ngalin/JillTrak/hardware/enclosure/renders/leads.png

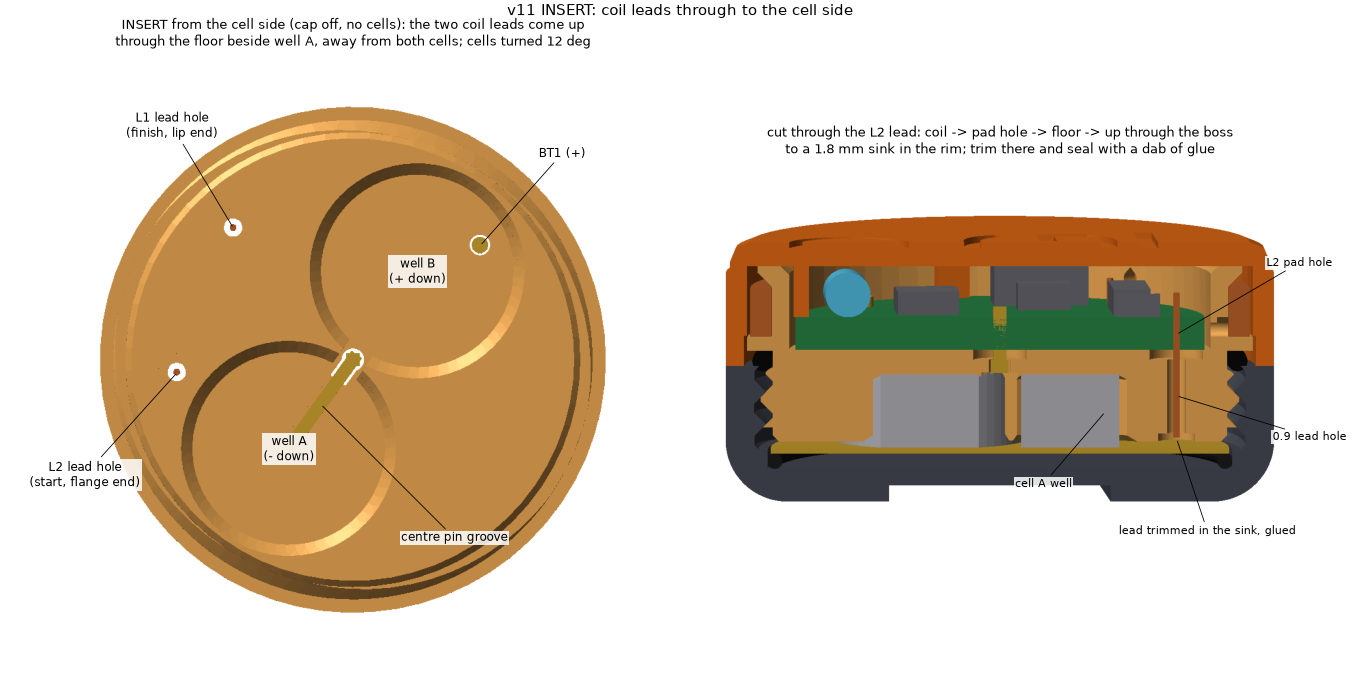
hardware/enclosure/renders/leads.png
