ngalin/JillTrak/hardware/enclosure/renders/thread.png

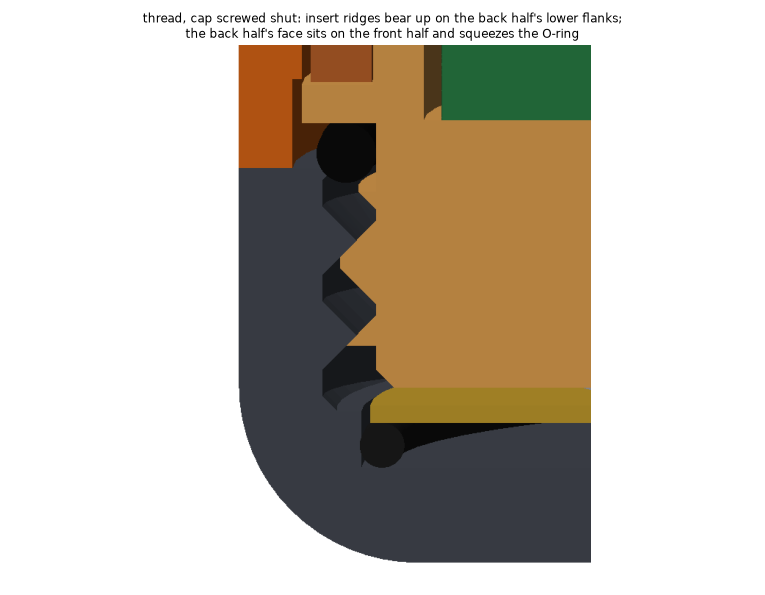
hardware/enclosure/renders/thread.png
