ngalin/JillTrak/hardware/pcb/tx-kick/bom.csv

Comment | Designator | Footprint | LCSC
Battery + side pin, 1.0mm, hand-fit | BT1 | Batt_Pos_SidePin_D1.0
Battery - centre pin, 1.0mm, hand-fit | BT2 | Batt_Neg_CentrePin_D1.0
Tank, 100nF C0G/NP0 50V | C1 | C_1206_3216Metric
Tank trim, C0G/NP0, fit only if needed | C1T | C_0603_1608Metric
100nF X7R 16V | C3 | C_0402_1005Metric
10uF X5R 6.3V | C4 | C_0603_1608Metric
100-220uF 6.3V polymer tantalum, case B (e.g. KEMET T520B) | C5 | CP_EIA-3528-21_Kemet-B
22uF X5R 6.3V | C5B | C_0805_2012Metric
Coil wire A, hand-solder | L1 | Coil_Wire_D0.7
Coil wire B, hand-solder | L2 | Coil_Wire_D0.7
AO3400A N-MOSFET, reverse-polarity | Q1 | SOT-23
AO3400A N-MOSFET, kick switch | Q2 | SOT-23
47R 1% | RF,RG | R_0402_1005Metric
100k 1% | RPD | R_0402_1005Metric
10k 1% | RR | R_0402_1005Metric
Standex-Meder MK24-B-2 reed, lead design 2 | SW1 | Reed_MK24_LeadDesign2
ATtiny85-20SU, SOIC-8 0.208 in | U1 | SOIC-8_5.23x5.23mm_P1.27mm
