ngalin/JillTrak/hardware/pcb/tx-kick/tx-kick_bom_jlc.csv

Comment | Designator | Footprint | JLCPCB Part #（optional）
100nF C0G | C1 | C1206 | C2940749
100nF | C3 | C0402 | C1525
10uF | C4 | C0603 | C19702
220uF | C5 | CAP-SMD_L3.5-W2.8 | C2158369
22uF | C5B | C0805 | C45783
AO3400A | Q1,Q2 | SOT-23-3 | C20917
47R | RF,RG | R0402 | C25118
100K | RPD | R0402 | C25741
10K | RR | R0402 | C25744
ATTINY85-20SU | U1 | SOIC-8_L5.3-W5.3-P1.27 | C31540447
