ngalin/JillTrak/hardware/enclosure/stl/insert.stl

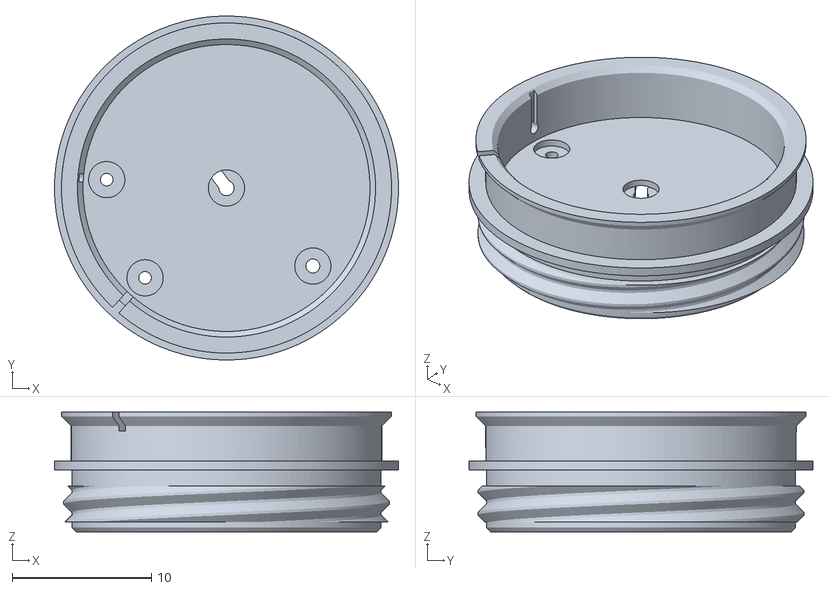
[picture p13: CAD file, 2026-10-30]
hardware/enclosure/stl/insert.stl
24.7 x 24.7 x 8.60
