ngalin/JillTrak/hardware/enclosure/stl/cap.stl

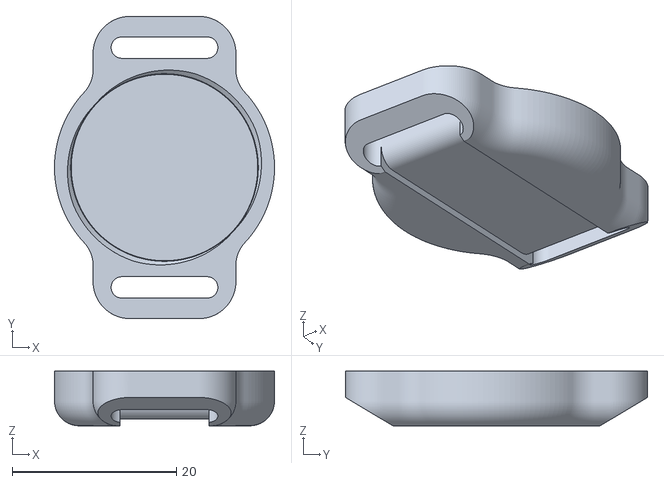
[picture p14: CAD file, 2026-10-30]
hardware/enclosure/stl/cap.stl
26.8 x 36.8 x 6.65
