ngalin/JillTrak/hardware/enclosure/stl/shell.stl

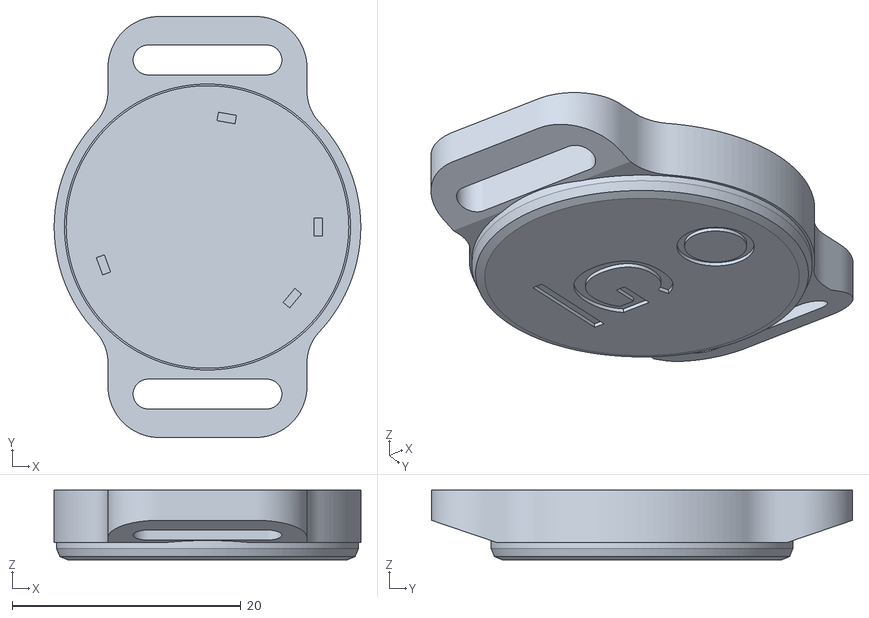
[picture p15: CAD file, 2026-10-30]
hardware/enclosure/stl/shell.stl
26.8 x 36.8 x 6.10
