ngalin/JillTrak/hardware/pcb/tx-kick/tx-kick-schematic.pdf

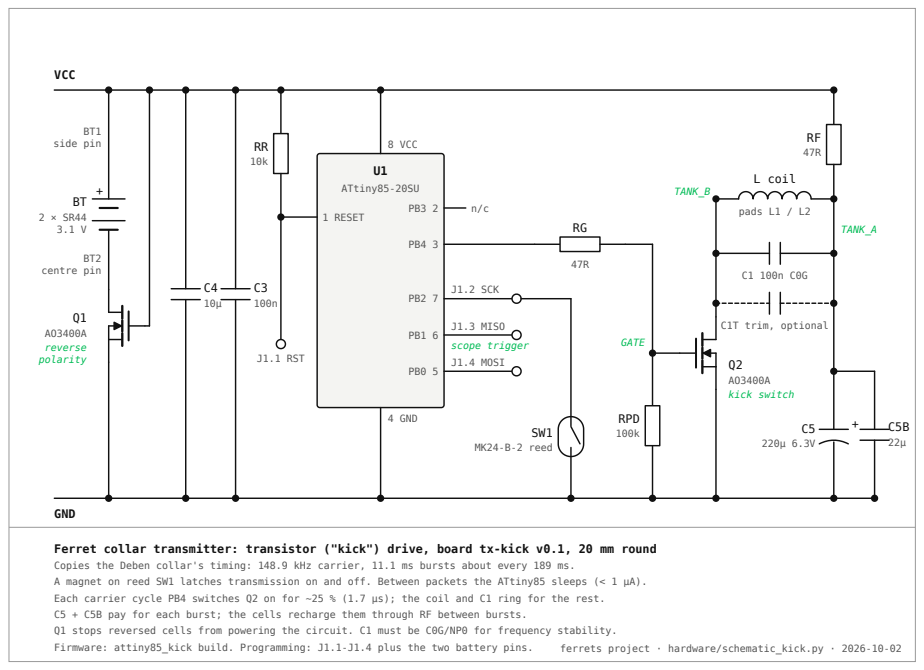
[picture p16: page 1]

Ferret collar transmitter: transistor ("kick") drive, board tx-kick v0.1, 20 mm round
Copies the Deben collar's timing: 148.9 kHz carrier, 11.1 ms bursts about every 189 ms.
A magnet on reed SW1 latches transmission on and off. Between packets the ATtiny85 sleeps (< 1 µA).
Each carrier cycle PB4 switches Q2 on for ~25 % (1.7 µs); the coil and C1 ring for the rest.
C5 + C5B pay for each burst; the cells recharge them through RF between bursts.
Q1 stops reversed cells from powering the circuit. C1 must be C0G/NP0 for frequency stability.
