ngalin/JillTrak/hardware/pcb/tx-kick/tx-kick.kicad_pcb

## KiCad design hardware/pcb/tx-kick/tx-kick.kicad_pcb (2026-10-30)

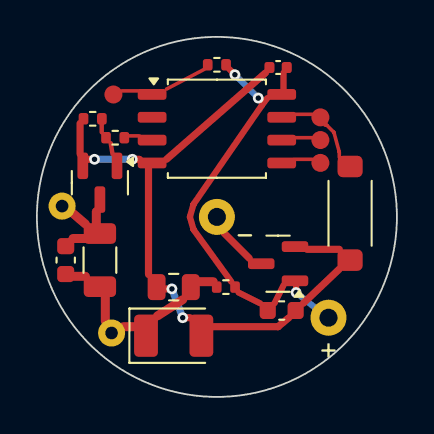
[picture p17: board tx-kick.kicad_pcb from above]

Board: 2 copper layers, 20.0 x 20.0 mm, 22 parts (0 on the bottom side), 11 nets.

Parts:
BT1: +; Batt_Pos_SidePin_D1.0
BT2: -; Batt_Neg_CentrePin_D1.0
C1: 100n C0G; C_1206_3216Metric
C1T: C0G trim; C_0603_1608Metric
C3: 100n; C_0402_1005Metric
C4: 10u; C_0603_1608Metric
C5: 220u 6.3V; CP_EIA-3528-21_Kemet-B
C5B: 22u; C_0805_2012Metric
J1.1: RST; ISP_Pad_D1.0
J1.2: SCK; ISP_Pad_D1.0
J1.3: MISO; ISP_Pad_D1.0
J1.4: MOSI; ISP_Pad_D1.0
L1: coil A; Coil_Wire_D0.7
L2: coil B; Coil_Wire_D0.7
Q1, Q2: AO3400A; SOT-23
RF: 47; R_0402_1005Metric
RG: 47; R_0402_1005Metric
RPD: 100k; R_0402_1005Metric
RR: 10k; R_0402_1005Metric
SW1: MK24-B-2; Reed_MK24_LeadDesign2
U1: ATtiny85-20SU; SOIC-8_5.23x5.23mm_P1.27mm

Connections:
BATNEG: BT2.1, Q1.3
GATE: Q2.1, RG.2, RPD.1
GND: C3.2, C4.2, C5.2, C5B.2, Q1.2, Q2.2, RPD.2, SW1.2, U1.4
PB0: J1.4.1, U1.5
PB1: J1.3.1, U1.6
PB2: J1.2.1, SW1.1, U1.7
PB4: RG.1, U1.3
RESET: J1.1.1, RR.2, U1.1
TANK_A: C1.1, C1T.1, C5.1, C5B.1, L1.1, RF.2
TANK_B: C1.2, C1T.2, L2.1, Q2.3
VCC: BT1.1, C3.1, C4.1, Q1.1, RF.1, RR.1, U1.8
